perseus784/Mobile-Multi-Robot-Logistics-System/Raspberry pi code for ARUCO (Neglected method)/rasp.py

import paho.mqtt.subscribe as subscribe
import time
import paho.mqtt.client as mqtt
import numpy as np
import cv2
import cv2.aruco as aruco
import serial
mqttc=mqtt.Client()
host='52.90.36.67'
ard_dire={'f':1,'l':2,'r':3,'b':4}
mqttc.connect(host,1883,60)
mqttc.loop_start()
cap = cv2.VideoCapture(0)
aru_size=132 #mm
focal_len=815.885212121
port = 'COM3'
ard = serial.Serial(port,9600,timeout=5)
global an
def on_message_print(client, userdata, message):
    global an
    an=(message.payload)
    print an
    client.disconnect()
def encoder(ids,direc):
    ctx=str(ids)+'||'+direc
    return ctx

def decoder(ctx):
    lis=ctx.split('|')
    return lis[0],lis[-1]

def logger(val):
    mqttc.publish("log",val, 2)
    pass
def arucoid(ide,dire,flag):
    global an
    print ide,dire
    while flag:
            ret, frame = cap.read()
            #print(frame.shape) #480x640
            # Our operations on the frame come here
            gray = cv2.cvtColor(frame, cv2.COLOR_BGR2GRAY)
            aruco_dict = aruco.Dictionary_get(aruco.DICT_5X5_50)
            #print aruco_dict
            parameters=aruco.DetectorParameters_create()
        
            '''    detectMarkers(...)
                detectMarkers(image, dictionary[, corners[, ids[, parameters[, rejectedI
                mgPoints]]]]) -> corners, ids, rejectedImgPoints
                '''
                #lists of ids and the corners beloning to each id
            corners, ids, rejectedImgPoints = aruco.detectMarkers(gray, aruco_dict, parameters=parameters)
        
            #print "im here"
            frame = aruco.drawDetectedMarkers(frame, corners)
        
            if len(corners):
                #print(corners)
                corners = corners[0][0]
                tl=corners[0]
                bl=corners[3]
                cv2.circle(frame,tuple(corners[0]),4,color=(255,0,0))
                cv2.circle(frame, tuple(corners[3]), 4, color=(0, 255, 0))
                #print tl,bl
                dist_px=np.linalg.norm(tl-bl)
                #print dist_px
                distance=(aru_size*focal_len)/dist_px
                #print distance
                '''pixel/focal=actual/dist'''
                ids=ids[0][0]

        
                if distance<1000:
                    if str(ids)==str(ide):
                        #print "im in"
                        #arduino.flush()
                        #arduino.write('4')
                        logger('@rasp found marker id {}'.format(ids))
                        '''
                        flagfile=open('flag.txt','w+')
                        flagfile.write('1')
                        flagfile.close()'''
                        #print ard_dire[dire]
                        print ide, dire
                        ard.write(str(ard_dire[dire]))
                        logger('@arduino sent to arduino')

                        # with the port open, the response will be buffered
                        # so wait a bit longer for response here

                        # Serial read section
                        time.sleep(2)

                        msg = ard.readline(ard.inWaiting())
                        logger('@arduino received {}'.format(msg))
                        print 'arduino',msg
                        print("found id no : {} \n in distance of : {}".format(ids,distance))
                        #time.sleep(1)
                        #arduino.write('1')
                        flag=False
                    cv2.putText(frame,str(ids),tuple(corners[2]),cv2.FONT_HERSHEY_SIMPLEX, 1, (0, 0, 255), 2)
                    
            #print(rejectedImgPoints)
            
            # Display the resulting frame
    
            #cv2.imshow('frame',frame)
            #if cv2.waitKey(1) & 0xFF == ord('q'):
            #   break
            
        

if __name__ =="__main__":
    logger('@rasp sucessfully launched robot')
    while 1:
        subscribe.callback(on_message_print, "rpi", hostname=host)
        print "received marker from cps", an
        ids, dire = decoder(an)
        logger('@rasp received marker {} from cps'.format(ids))

        arucoid(ids, dire, flag=True)
        # time.sleep(3)
        logger('@rasp found one marker moving to next marker')
        mqttc.publish("cps", ids, 2)
        print "sending to cps"
mqttc.loop_stop()
mqttc.disconnect()
