perseus784/Mobile-Multi-Robot-Logistics-System/Raspberry pi code for ARUCO (Neglected method)/version.py

# -*- coding: utf-8 -*-

# Form implementation generated from reading ui file 'version.ui'
#
# Created: Thu Sep  7 13:16:30 2017
#      by: PyQt4 UI code generator 4.10.4
#
# WARNING! All changes made in this file will be lost!

from PyQt4 import QtCore, QtGui
import paho.mqtt.client as mqtt
mqttc=mqtt.Client()
mqttc.connect("localhost",1883,60)
mqttc.loop_start()
try:
    _fromUtf8 = QtCore.QString.fromUtf8
except AttributeError:
    def _fromUtf8(s):
        return s

try:
    _encoding = QtGui.QApplication.UnicodeUTF8
    def _translate(context, text, disambig):
        return QtGui.QApplication.translate(context, text, disambig, _encoding)
except AttributeError:
    def _translate(context, text, disambig):
        return QtGui.QApplication.translate(context, text, disambig)

class Ui_Form(object):
    def setupUi(self, Form):
        Form.setObjectName(_fromUtf8("Form"))
        Form.resize(526, 450)
        self.toolButton_2 = QtGui.QToolButton(Form)
        self.toolButton_2.setGeometry(QtCore.QRect(240, 150, 261, 61))
        self.toolButton_2.setObjectName(_fromUtf8("toolButton_2"))
        self.toolButton_3 = QtGui.QToolButton(Form)
        self.toolButton_3.setGeometry(QtCore.QRect(240, 210, 261, 61))
        self.toolButton_3.setObjectName(_fromUtf8("toolButton_3"))
        self.toolButton_4 = QtGui.QToolButton(Form)
        self.toolButton_4.setGeometry(QtCore.QRect(240, 270, 261, 61))
        self.toolButton_4.setObjectName(_fromUtf8("toolButton_4"))
        self.textEdit = QtGui.QTextEdit(Form)
        self.textEdit.setGeometry(QtCore.QRect(80, 40, 371, 61))
        self.textEdit.setObjectName(_fromUtf8("textEdit"))

        self.retranslateUi(Form)
        QtCore.QObject.connect(self.toolButton_2, QtCore.SIGNAL(_fromUtf8("clicked()")), self.meesag1)
        QtCore.QObject.connect(self.toolButton_3, QtCore.SIGNAL(_fromUtf8("clicked()")), self.Message2)
        QtCore.QObject.connect(self.toolButton_4, QtCore.SIGNAL(_fromUtf8("clicked()")), self.message3)
        QtCore.QMetaObject.connectSlotsByName(Form)

    def meesag1(self):
		print "Cofee"
                mqttc.publish("paho/New","coffee",2)
    def Message2(self):
		print "Tea"
                mqttc.publish("paho/New","tea",2)              
    def message3(self):
		print "Snacks"
                mqttc.publish("paho/New","snacks",2)  

    def retranslateUi(self, Form):
        Form.setWindowTitle(_translate("Form", "Form", None))
        self.toolButton_2.setText(_translate("Form", "Coffee", None))
        self.toolButton_3.setText(_translate("Form", "Tea", None))
        self.toolButton_4.setText(_translate("Form", "Snacks", None))
        self.textEdit.setHtml(_translate("Form", "<!DOCTYPE HTML PUBLIC \"-//W3C//DTD HTML 4.0//EN\" \"http://www.w3.org/TR/REC-html40/strict.dtd\">\n"
"<html><head><meta name=\"qrichtext\" content=\"1\" /><style type=\"text/css\">\n"
"p, li { white-space: pre-wrap; }\n"
"</style></head><body style=\" font-family:\'Ubuntu\'; font-size:11pt; font-weight:400; font-style:normal;\">\n"
"<p style=\" margin-top:0px; margin-bottom:0px; margin-left:0px; margin-right:0px; -qt-block-indent:0; text-indent:0px;\"><span style=\" font-size:26pt; font-weight:600;\">WARE HOUSE ROBOT</span></p></body></html>", None))


if __name__ == "__main__":
    import sys
    app = QtGui.QApplication(sys.argv)
    Form = QtGui.QWidget()
    ui = Ui_Form()
    ui.setupUi(Form)
    Form.show()
    sys.exit(app.exec_())
    mqttc.loop_stop()
    mqttc.disconnect()
