perseus784/Mobile-Multi-Robot-Logistics-System/(commit log)

2017-09-22 crossref.csv created online with Bitbucket
    [crossref.csv]
2017-09-28 crossref4.csv created online with Bitbucket
    [crossref4.csv]
2018-11-22 RM Code Folder
    [crossref4.csv]
2018-11-25 updated structure
    [crossref.csv, crossref4.csv]
2018-11-25 files
    Former-commit-id: f4c16032dae0675bba99f096daae8f2f84b123ed
    [crossref4.csv]
2018-11-25 files
    Former-commit-id: 51d9dd9f4c6532b304c1729ce1a750a245aa2898
    [cross1.csv, crossref.csv]
